fuzikong114/Graduation-project/hardware/stm32-environment-monitor/docs/原理图.png

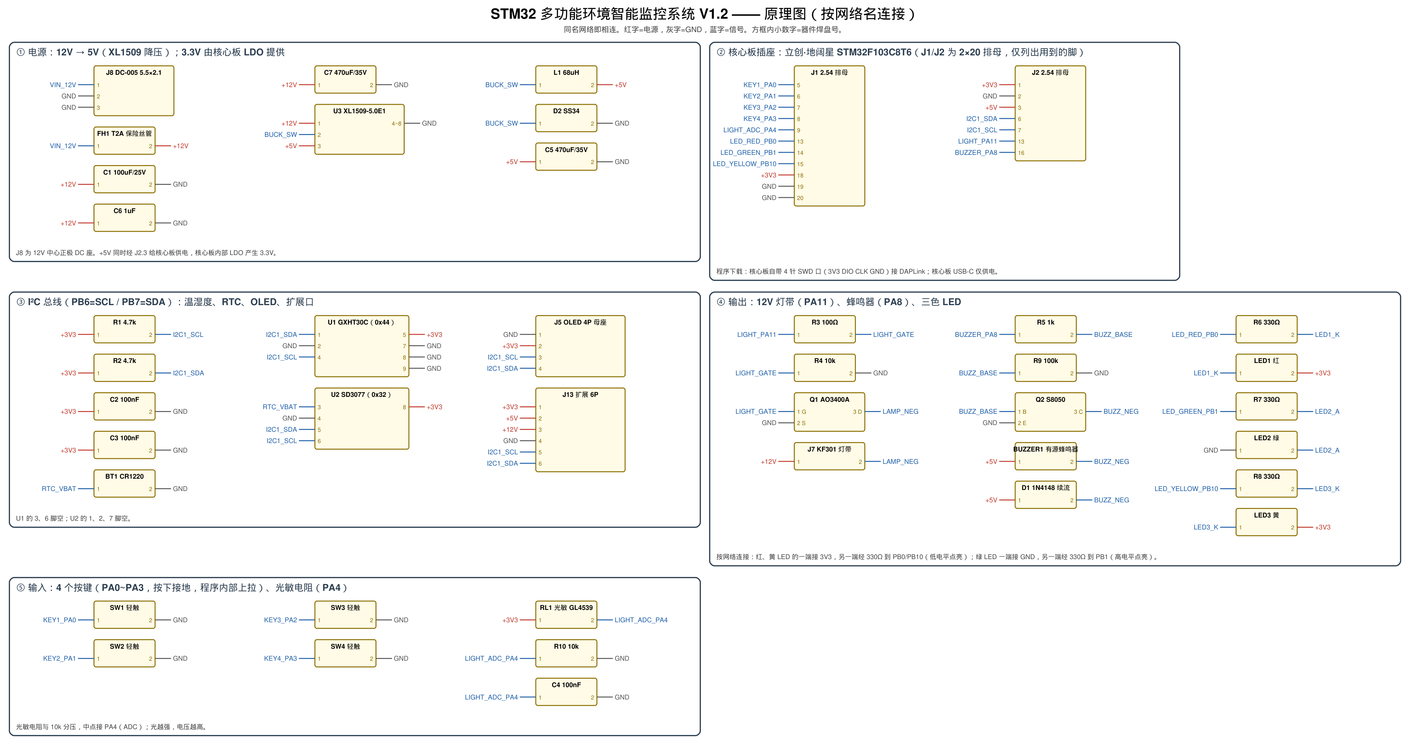
hardware/stm32-environment-monitor/docs/原理图.png
