fuzikong114/Graduation-project/hardware/stm32-environment-monitor/fabrication/BOM_STM32_Env_Monitor_V1.2.csv

No. | Quantity | Comment | Designator | Footprint | Value | Manufacturer Part | Manufacturer | Supplier Part | Supplier | LCSC
1 | 1 | KH-CR1220-2 | BT1 | BAT-SMD_CR1220-2 |  | KH-CR1220-2 | kinghelm(金航标) | C5365933 | LCSC
2 | 1 | 2.4kHz | BUZZER1 | BUZ-TH_BD12.0-P7.60-D0.6-FD | 2.4kHz | TMB12A05 | 华能 | C96093 | LCSC
3 | 1 | 100uF | C1 | CAP-TH_BD6.3-P2.50-D0.5-FD | 100uF | ERG25V100M6X7 | JIERR(捷而瑞) | C48935385 | LCSC
4 | 3 | 100nF | C2,C3,C4 | C0603 | 100nF | 0603B104K500NT | FH(风华) | C30926 | LCSC
5 | 2 | 470uF | C5,C7 | CAP-SMD_BD10.0-L10.3-W10.3-LS11.3-FD | 470uF | RVE470UF35V167RV084 | KNSCHA(科尼盛) | C5155332 | LCSC
6 | 1 | 1uF | C6 | C0805 | 1uF | CT41G-0805-2X1-50V-1uF-K(N) | TORCH(火炬) | C141772 | LCSC
7 | 1 | 1N4148TR | D1 | DO-35_BD2.0-L4.2-P8.20-D0.5-RD |  | 1N4148TR | onsemi(安森美) | C84410 | LCSC
8 | 1 | SS34 | D2 | SMA_L4.3-W2.6-LS5.0-RD |  | SS34 | MDD(辰达半导体) | C8678 | LCSC
9 | 1 | FH1-200CK-G | FH1 | FUSE-TH_L24.8-W9.8-P22.60 |  | FH1-200CK-G | HONGJU(宏聚) | C268204 | LCSC
10 | 2 | KH-2.54FH-1X20P-H8.5 | J1,J2 | HDR-TH_20P-P2.54-V-F-2 |  | KH-2.54FH-1X20P-H8.5 | kinghelm(金航标) | C2905423 | LCSC
11 | 1 | 2.54-1*4P母 | J5 | HDR-TH_4P-P2.54-V-F |  | 2.54-1*4P母 | BOOMELE(博穆精密) | C2718488 | LCSC
12 | 1 | KF301-5.0-2P | J7 | CONN-TH_P5.00_KF301-5.0-2P |  | KF301-5.0-2P | KEFA(科发) | C474881 | LCSC
13 | 1 | DC-005-5A-2.0 | J8 | DC-IN-TH_DC-005-5A-2.0 |  | DC-005-5A-2.0 | XKB Connection(中国星坤) | C381116 | LCSC
14 | 1 | 2.54-1x6P直针 | J13 | HDR-TH_6P-P2.54-V-M-1 |  | 2.54-1x6P直针 | BOOMELE(博穆精密) | C37208 | LCSC
15 | 1 | 68uH | L1 | IND-SMD_L8.0-W8.0_SMNR8040 | 68uH | SWPA8040S680MT | Sunlord(顺络) | C36418 | LCSC
16 | 1 | XL-502SURD | LED1 | LED-TH_BD5.9-P2.54-RD_RED |  | XL-502SURD | XINGLIGHT(成兴光) | C2895492 | LCSC
17 | 1 | XL-502SYGD | LED2 | LED-TH_BD5.8-P2.54-RD |  | XL-502SYGD | XINGLIGHT(成兴光) | C2895550 | LCSC
18 | 1 | XL-502UYD | LED3 | LED-TH_BD5.9-P2.54-RD_YELLOW |  | XL-502UYD | XINGLIGHT(成兴光) | C2895494 | LCSC
19 | 1 | AO3400A | Q1 | SOT-23-3_L2.9-W1.3-P1.90-LS2.4-BR |  | AO3400A | AOS | C20917 | LCSC
20 | 1 | S8050(0.5A) | Q2 | SOT-23-3_L2.9-W1.3-P1.90-LS2.4-BR |  | S8050(0.5A) | EIC | C3014350 | LCSC
21 | 2 | 4.7kΩ | R1,R2 | R0603 | 4.7kΩ | 0603WAF4701T5E | UNI-ROYAL(厚声) | C23162 | LCSC
22 | 1 | 100Ω | R3 | R0603 | 100Ω | 0603WAF1000T5E | UNI-ROYAL(厚声) | C22775 | LCSC
23 | 2 | 10kΩ | R4,R10 | R0603 | 10kΩ | 0603WAF1002T5E | UNI-ROYAL(厚声) | C25804 | LCSC
24 | 1 | 1kΩ | R5 | R0603 | 1kΩ | 0603WAF1001T5E | UNI-ROYAL(厚声) | C21190 | LCSC
25 | 3 | 330Ω | R6,R7,R8 | R0603 | 330Ω | 0603WAF3300T5E | UNI-ROYAL(厚声) | C23138 | LCSC
26 | 1 | 100kΩ | R9 | R0603 | 100kΩ | 0603WAF1003T5E | UNI-ROYAL(厚声) | C25803 | LCSC
27 | 1 | GL4539（30-40K） | RL1 | CAP-TH_BD6.3-P2.50-D0.5-FD |  | GL4539（30-40K） | JCHL(晶创和立) | C11295 | LCSC
28 | 4 | TS-1187A-B-A-B | SW1,SW2,SW3,SW4 | SW-SMD_4P-L5.1-W5.1-P3.70-LS6.5-TL_H1.5 |  | TS-1187A-B-A-B | XKB Connection(中国星坤) | C318884 | LCSC
29 | 1 | GXHT30C | U1 | DFN-8_L2.5-W2.5-P0.50-BL-EP |  | GXHT30C | GXCAS(中科银河芯) | C2913569 | LCSC
30 | 1 | SD3077 | U2 | SOIC-8_L5.3-W5.3-P1.27-LS8.0-BL |  | SD3077 | WAVE(兴威帆电子) | C4748679 | LCSC
31 | 1 | XL1509-5.0E1 | U3 | SOIC-8_L5.0-W4.0-P1.27-LS6.0-BL |  | XL1509-5.0E1 | XLSEMI(芯龙) | C61063 | LCSC
