fuzikong114/Graduation-project/(list of files, drawings)

Other design files:
hardware/stm32-environment-monitor/archive/STM32-Environment-Monitor-SMD-DRAFT.epro
hardware/stm32-environment-monitor/archive/V1.0-module/STM32-Environment-Monitor-V1.0.epro
hardware/stm32-environment-monitor/archive/V1.1-domestic/STM32-Environment-Monitor-V1.1.epro
hardware/stm32-environment-monitor/STM32-Environment-Monitor-DRAFT.epro
hardware/stm32-environment-monitor/STM32-Environment-Monitor-V1.0.epro
hardware/stm32-environment-monitor/STM32-Environment-Monitor-V1.1.epro
hardware/stm32-environment-monitor/STM32-Environment-Monitor-V1.2.epro
