fuzikong114/Graduation-project/hardware/parking-bluepill/parking_smd.kicad_pcb

## KiCad design hardware/parking-bluepill/parking_smd.kicad_pcb (2026-11-12)

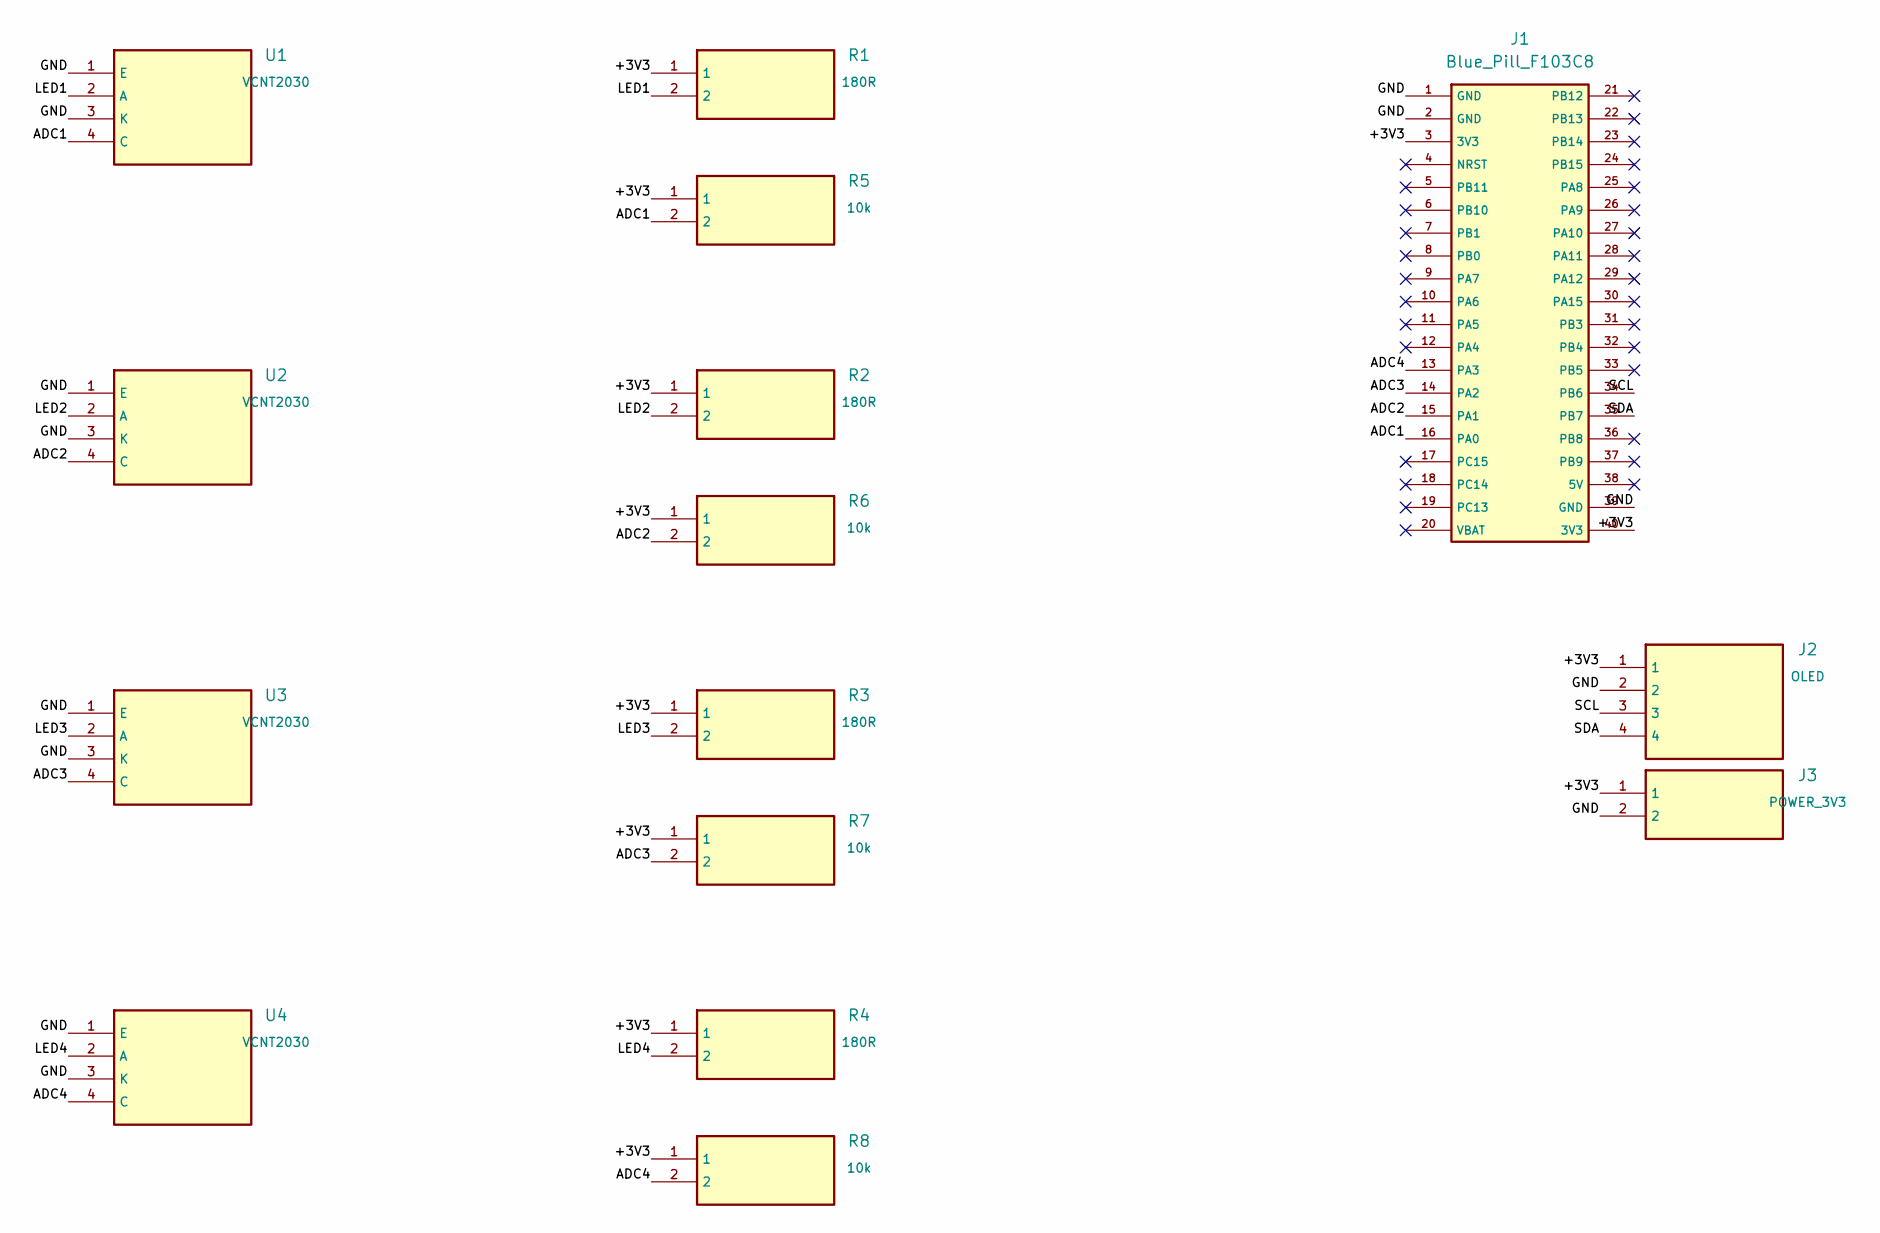
[picture p3: schematic parking_smd.kicad_sch]

Parts:
J1: Blue_Pill_F103C8; BluePill_2x20_P2.54_Row15.24
J2: OLED; PinHeader_1x04_P2.54mm_Vertical
J3: POWER_3V3; PinHeader_1x02_P2.54mm_Vertical
R1, R2, R3, R4: 180R; R_0805_2012Metric
R5, R6, R7, R8: 10k; R_0805_2012Metric
U1, U2, U3, U4: VCNT2030

Connections:
/+3V3: J1.3 (3V3), J1.40 (3V3), J2.1, J3.1, R1.1, R2.1, R3.1, R4.1, R5.1, R6.1, R7.1, R8.1
/ADC1: J1.16 (PA0), R5.2, U1.4 (C)
/ADC2: J1.15 (PA1), R6.2, U2.4 (C)
/ADC3: J1.14 (PA2), R7.2, U3.4 (C)
/ADC4: J1.13 (PA3), R8.2, U4.4 (C)
/GND: J1.1 (GND), J1.2 (GND), J1.39 (GND), J2.2, J3.2, U1.1 (E), U1.3 (K), U2.1 (E), U2.3 (K), U3.1 (E), U3.3 (K), U4.1 (E), U4.3 (K)
/LED1: R1.2, U1.2 (A)
/LED2: R2.2, U2.2 (A)
/LED3: R3.2, U3.2 (A)
/LED4: R4.2, U4.2 (A)
/SCL: J1.34 (PB6), J2.3
/SDA: J1.35 (PB7), J2.4

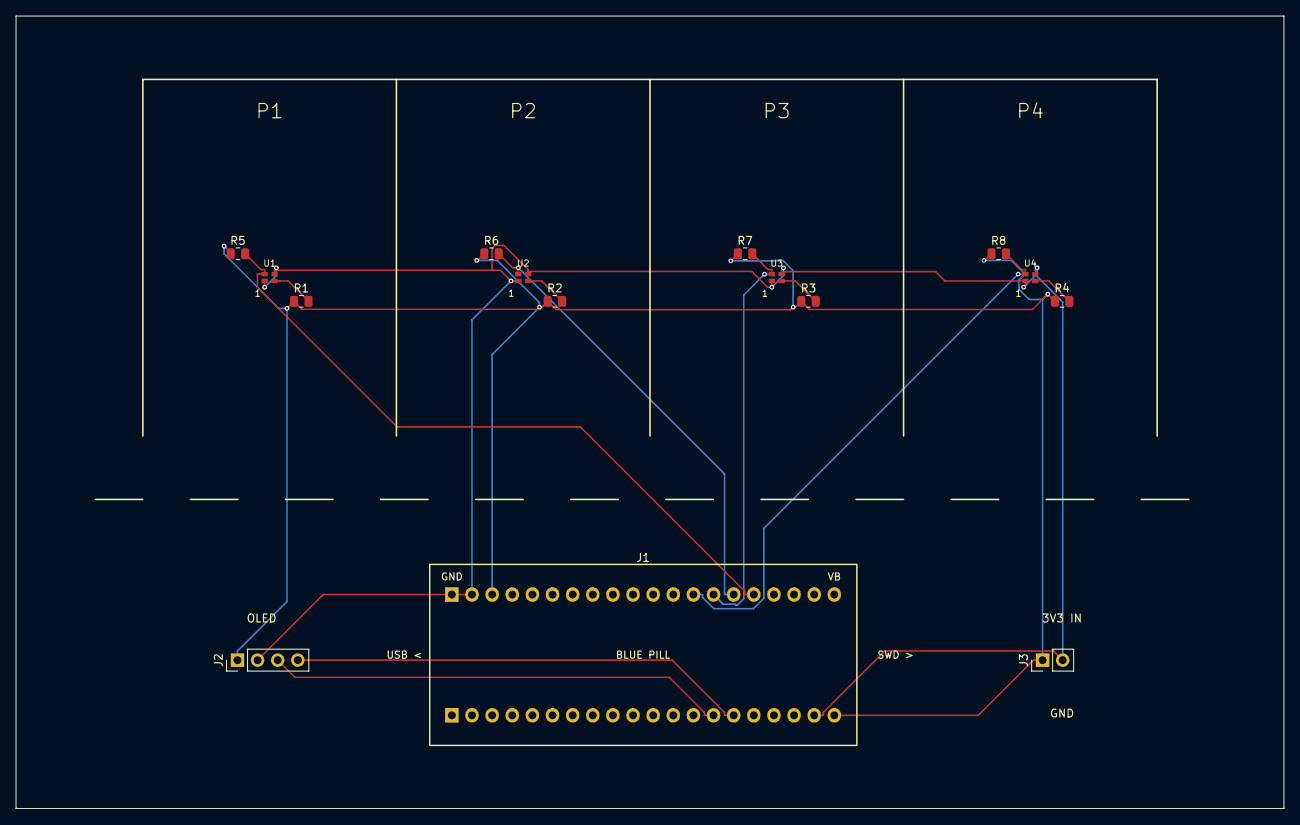
[picture p4: board parking_smd.kicad_pcb from above]

Board: 2 copper layers, 160.0 x 100.0 mm, 15 parts (0 on the bottom side), 12 nets.
