fuzikong114/Graduation-project/(commit log)

2026-11-12 Initialize four-space parking KiCad project
2026-11-12 Add four-space parking schematic and PCB layout
    [parking_smd.kicad_pcb, parking_smd.kicad_sch]
2026-11-12 Document STM32 environment monitor hardware draft
2026-11-13 Release STM32 environment monitor hardware V1.0 (module version)
    - Board1 now uses only the module-based schematic page; SMD sensor/OLED
    draft pages moved to an unattached SMD_Draft_Archive schematic
    - Add GND copper pours on top and bottom layers
    - Replace DRAFT silkscreen with board title
    - Schematic DRC: 0 errors; PCB DRC: 141 checks, 0 issues, 0 unrouted
    - Add Gerber, BOM and pick-and-place exports for fabrication
    [BOM_STM32_Env_Monitor_V1.0.csv, PickAndPlace_STM32_Env_Monitor_V1.0.csv, STM32-Environment-Monitor-SMD-DRAFT.epro, STM32-Environment-Monitor-V1.0.epro]
2026-11-13 Release STM32 environment monitor hardware V1.1 (domestic SMD parts)
    - Main board: LCKFB-DKX-STM32F103C8T6 (C22396880), pin-compatible with
    Blue Pill, plugged into J1/J2
    - Temp/humidity: on-board GXHT30 (GXCAS) replaces SHT30 module
    - RTC: on-board SD3077 (WAVE) with CR1220 holder replaces DS3231 module
    - Light: GL4539 photoresistor divider to PA4 (ADC) replaces BH1750 module
    - OLED: J5 changed to 4P female socket, pin order GND/3V3/SCL/SDA
    - Remove J11/J12 SWD headers; programming via the board's USB-C
    - Schematic DRC: 0 errors; PCB DRC: 0 errors, 0 unrouted
    - Move V1.0 files to archive/V1.0-module
    [BOM_STM32_Env_Monitor_V1.0.csv, BOM_STM32_Env_Monitor_V1.1.csv, PickAndPlace_STM32_Env_Monitor_V1.0.csv, PickAndPlace_STM32_Env_Monitor_V1.1.csv, STM32-Environment-Monitor-V1.0.epro, STM32-Environment-Monitor-V1.1.epro]
2026-11-13 Clear schematic DRC warnings in V1.1
    - Remove duplicate LIGHT_ADC_PA4 net label on the RL1-R10 wire
    - Mark unused pins U1.3/U1.6/U2.1/U2.2/U2.7 as no-connect
    - Restore part-number names on J7-J10 and FH1; keep function labels
    as schematic text
    - Re-export Gerber, BOM, pick-and-place and EPRO
    [BOM_STM32_Env_Monitor_V1.1.csv, PickAndPlace_STM32_Env_Monitor_V1.1.csv, STM32-Environment-Monitor-V1.1.epro]
2026-11-13 Release STM32 environment monitor hardware V1.2 (on-board power)
    - 12V input: J8 terminal block replaced by DC-005 jack (5.5x2.1, XKB)
    - 5V: on-board XL1509-5.0E1 buck (68uH Sunlord inductor, SS34,
    470uF in/out caps) replaces the external LM2596 module; J9/J10 removed
    - Power circuit on new schematic page POWER
    - README: correct programming method (SWD via DAP-Link/ST-Link; the
    dev board's USB-C cannot flash the STM32F103 directly)
    - Move V1.1 files to archive/V1.1-domestic
    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
    [BOM_STM32_Env_Monitor_V1.1.csv, BOM_STM32_Env_Monitor_V1.2.csv, PickAndPlace_STM32_Env_Monitor_V1.1.csv, PickAndPlace_STM32_Env_Monitor_V1.2.csv, STM32-Environment-Monitor-V1.1.epro, STM32-Environment-Monitor-V1.2.epro]
2026-11-13 Fix J2 orientation and layout issues in V1.2
    - J2 socket was rotated 180 deg since V1.0, so its pin 1 (3V3) sat at
    the opposite end from J1 pin 1 (BAT); on the real dev board BAT and
    3V3 share an end, so every J2 signal would have been misaligned.
    J2 now matches the LCKFB-DKX pinout column by column.
    - Spread out buck parts (C6 no longer inside C7 outline), upright
    designators for C5/C6/C7
    - Move J13 test header out from under the dev board edge
    - Move silkscreen notes off U2/BT1; title to V1.2
    - Re-route affected nets; PCB DRC: 0 errors, 0 unrouted
    - README: mark V1.0/V1.1 archives as not for fabrication
    [PickAndPlace_STM32_Env_Monitor_V1.2.csv, STM32-Environment-Monitor-V1.2.epro]
2026-11-14 Stitch GND copper between layers to remove large floating blocks
    Add ~300 GND vias across the board (about 6 mm pitch) so the top and
    bottom pours are tied together and the large unconnected bottom-layer
    copper areas are covered. No schematic or BOM change.
    PCB DRC: 0 errors, 0 unrouted.
    [STM32-Environment-Monitor-V1.2.epro]
2026-11-14 Replace discontinued GXHT30 with GXHT30C (C2913569) in V1.2
    C3010791 (GXHT30) is discontinued at LCSC. GXHT30C has identical pin
    names/numbers and the same DFN-8 2.5x2.5 footprint, so copper, solder
    mask and drill data are unchanged; only BOM and project attributes change.
    [BOM_STM32_Env_Monitor_V1.2.csv, PickAndPlace_STM32_Env_Monitor_V1.2.csv, STM32-Environment-Monitor-V1.2.epro]
2026-11-14 Add schematic and wiring diagrams; record SD3077 datasheet verification
